dirkt68/pl3-pulseox/README.md

# Project Lab 3
## Digital Communications Project Lab
