dirkt68/pl3-pulseox/report/dirk/fe_grade_thieme.png

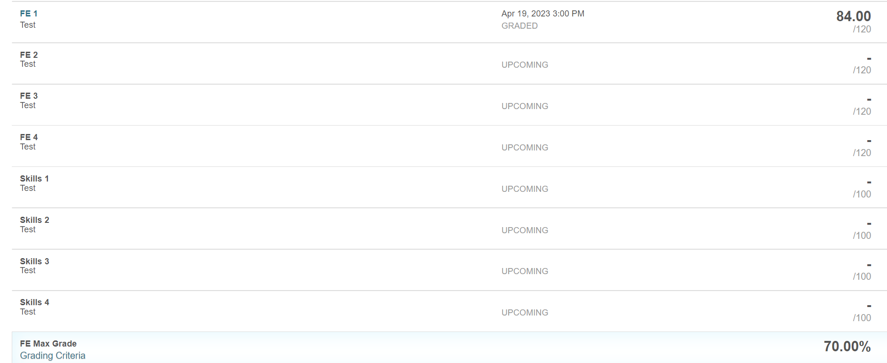
report/dirk/fe_grade_thieme.png
