dirkt68/pl3-pulseox/pcb/IC_PCB_v2/production/bom.csv

Designator | Footprint | Quantity | Value | LCSC Part #
C1 | 0603 | 1 | 2u2
C2 | 0603 | 1 | 2u2
C3 | 0603 | 1 | 10u
C4 | 0201 | 1 | 0u1
C5 | 0201 | 1 | 0u1
C6 | 0201 | 1 | 4u7
C7 | 0603 | 1 | 10u
C8 | 0201 | 1 | 0u7
C9 | 0201 | 1 | 0u1
IC1 | 14-LEAD-OESIP | 1 | MAX30102EFD+
IC2 | SON65P300X300X80-9N | 1 | MAX30205MTA+
J1 | 0522070433 | 1 | 52207-0460
R3 | 0201 | 1 | 4.7k
R4 | 0201 | 1 | 4.7k
R5 | 0201 | 1 | 4k7
R6 | 0201 | 1 | 4k7
U2 | TSOT-23-5 | 1 | ADP7182AUJZ-1.8
