dirkt68/pl3-pulseox/report/dirk/final/images/uc_setup_2.png

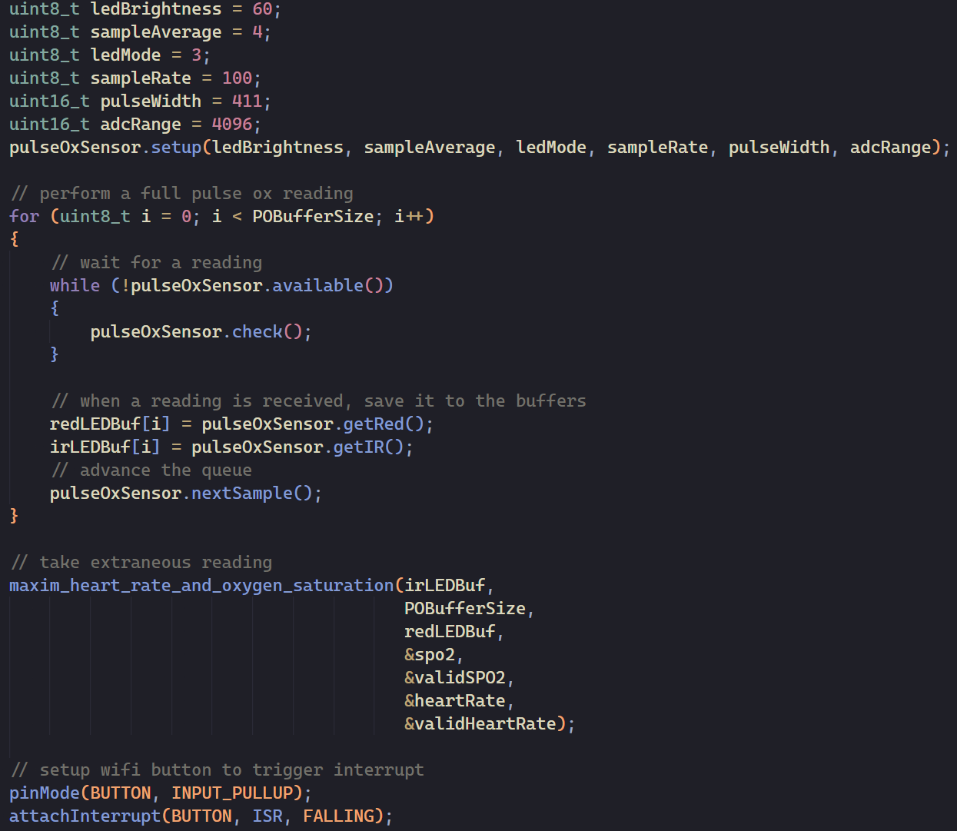
report/dirk/final/images/uc_setup_2.png
