dirkt68/pl3-pulseox/pcb/pulse_ox_wearable/pulse_ox_wearable.kicad_pcb

## KiCad design pcb/pulse_ox_wearable/pulse_ox_wearable.kicad_pcb (2023-04-01)

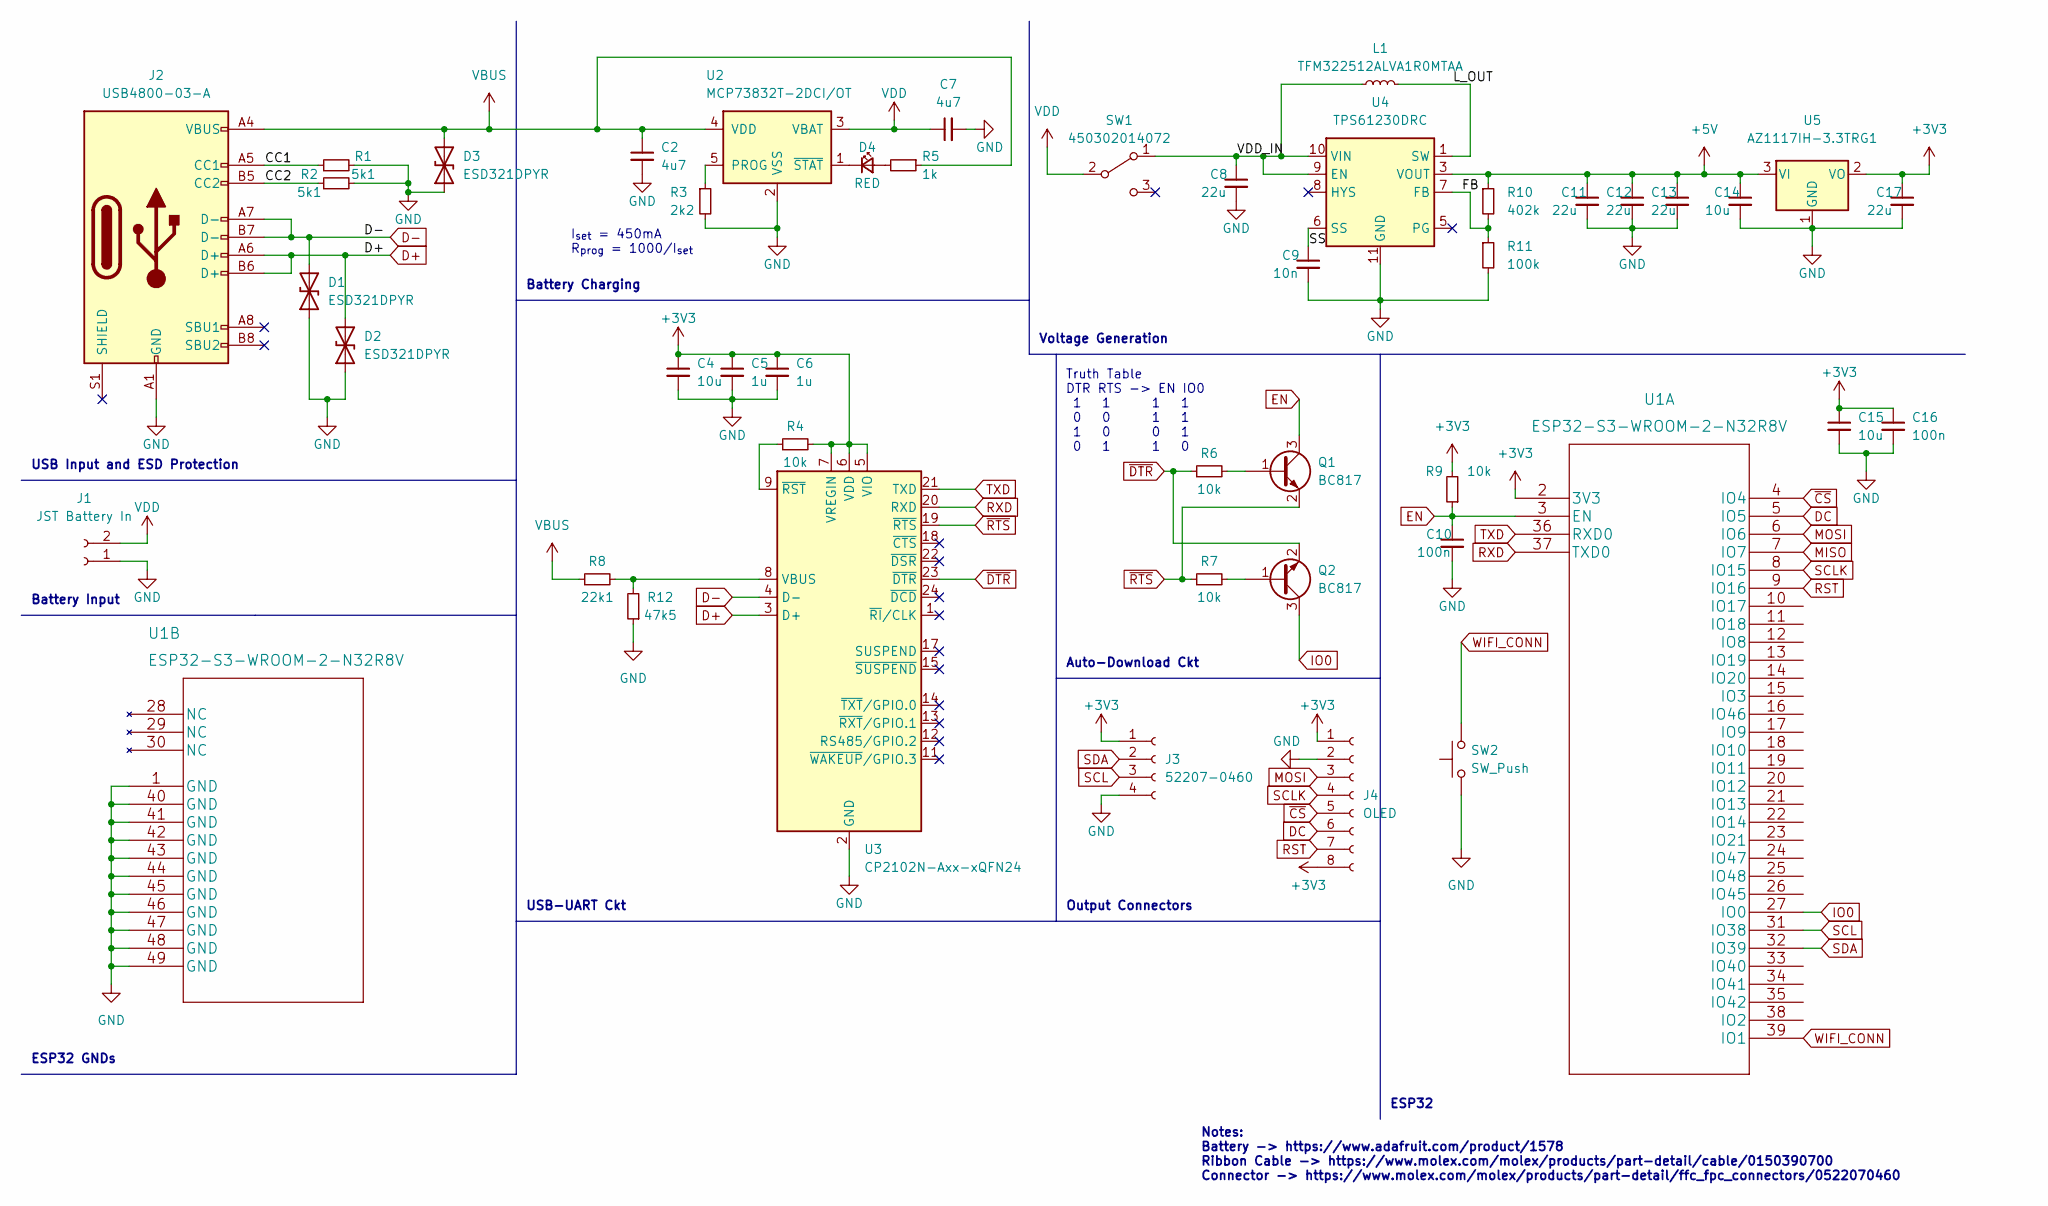
[picture p39: schematic pulse_ox_wearable.kicad_sch, Project Lab 3 - Main Board]

Parts:
C2, C7: 4u7; C_0603_1608Metric
C4, C14, C15: 10u; C_0805_2012Metric
C5, C6: 1u; C_0805_2012Metric
C8, C11, C12, C13, C17: 22u; C_1206_3216Metric
C9: 10n; C_0201_0603Metric
C10, C16: 100n; C_0603_1608Metric
D1, D2, D3: ESD321DPYR; D_0402_1005Metric
D4: RED; LED_0603_1608Metric
J1: JST Battery In; JST_PH_B2B-PH-K_1x02_P2.00mm_Vertical
J2: USB4800-03-A; USB_C_Receptacle_HRO_TYPE-C-31-M-12
J3: 52207-0460; 0522070433
J4: OLED; PinHeader_1x08_P2.54mm_Vertical
L1: TFM322512ALVA1R0MTAA; L_1210_3225Metric
Q1, Q2: BC817; SOT-23
R1, R2: 5k1; R_0201_0603Metric
R3: 2k2; R_0201_0603Metric
R4, R6, R7, R9: 10k; R_1210_3225Metric
R5: 1k; R_0805_2012Metric
R8: 22k1; R_0402_1005Metric
R10: 402k; R_0603_1608Metric
R11: 100k; R_0603_1608Metric
R12: 47k5; R_0402_1005Metric
SW1: 450302014072; SS12D00(SPDT amazon)
SW2: SW_Push; SW_SPST_B3U-1000P
U1: ESP32-S3-WROOM-2-N32R8V
U2: MCP73832T-2DCI/OT; SOT-23-5
U3: CP2102N-Axx-xQFN24; QFN-24-1EP_4x4mm_P0.5mm_EP2.6x2.6mm
U4: TPS61230DRC; Texas_S-PVSON-N10_ThermalVias
U5: AZ1117IH-3.3TRG1; SOT-223

Connections:
+3V3: C4.1, C5.1, C6.1, C15.1, C16.1, C17.1, J3.1, J4.1, J4.8, R4.2, R9.2, U1.2 (3V3), U3.5 (VIO), U3.6 (VDD), U3.7 (VREGIN), U5.2 (VO)
+5V: C11.1, C12.1, C13.1, C14.1, R10.1, U4.3 (VOUT), U4.4 (VOUT), U5.3 (VI)
/CC1: J2.A5 (CC1), R1.1
/CC2: J2.B5 (CC2), R2.1
/FB: R10.2, R11.1, U4.7 (FB)
/L_OUT: L1.2, U4.1 (SW), U4.2 (SW)
/SS: C9.1, U4.6 (SS)
/VDD_IN: C8.1, L1.1, SW1.1 (A), U4.9 (EN), U4.10 (VIN)
D+: D2.2 (A2), J2.A6 (D+), J2.B6 (D+), U3.3 (D+)
D-: D1.2 (A2), J2.A7 (D-), J2.B7 (D-), U3.4 (D-)
DC: J4.6, U1.5 (IO5)
EN: C10.1, Q1.3 (C), R9.1, U1.3 (EN)
GND: C2.2, C4.2, C5.2, C6.2, C7.2, C8.2, C9.2, C10.2, C11.2, C12.2, C13.2, C14.2, C15.2, C16.2, C17.2, D1.1 (A1), D2.1 (A1), D3.1 (A1), J1.1, J2.A1 (GND), J2.A12 (GND), J2.B1 (GND), J2.B12 (GND), J3.4, J4.2, R1.2, R2.2, R3.2, R11.2, R12.1, SW2.1, U1.1 (GND), U1.40 (GND), U1.41 (GND), U1.42 (GND), U1.43 (GND), U1.44 (GND), U1.45 (GND), U1.46 (GND), U1.47 (GND), U1.48 (GND), U1.49 (GND), U2.2 (VSS), U3.2 (GND), U3.25 (GND), U4.11 (GND), U5.1 (GND)
IO0: Q2.3 (C), U1.27 (IO0)
MISO: U1.7 (IO7)
MOSI: J4.3, U1.6 (IO6)
unnamed: D4.2 (A), R5.2
unnamed: D4.1 (K), U2.1 (~STAT)
unnamed: Q1.1 (B), R6.2
unnamed: Q2.1 (B), R7.2
unnamed: R3.1, U2.5 (PROG)
unnamed: R8.2, R12.2, U3.8 (VBUS)
unnamed: R4.1, U3.9 (~RST)
RST: J4.7, U1.9 (IO16)
RXD: U1.37 (TXD0), U3.20 (RXD)
SCL: J3.3, U1.31 (IO38)
SCLK: J4.4, U1.8 (IO15)
SDA: J3.2, U1.32 (IO39)
TXD: U1.36 (RXD0), U3.21 (TXD)
VBUS: C2.1, D3.2 (A2), J2.A4 (VBUS), J2.A9 (VBUS), J2.B4 (VBUS), J2.B9 (VBUS), R5.1, R8.1, U2.4 (VDD)
VDD: C7.1, J1.2, SW1.2 (B), U2.3 (VBAT)
WIFI_CONN: SW2.2, U1.39 (IO1)
~CS: J4.5, U1.4 (IO4)
~DTR: Q2.2 (E), R6.1, U3.23 (~DTR)
~RTS: Q1.2 (E), R7.1, U3.19 (~RTS)

Notes on the sheet:
I_{set} = 450mA R_{prog} = 1000/I_{set}
Voltage Generation
Battery Input
Truth Table DTR RTS -> EN IO0 1 1 1 1 0 0 1 1 1 0 0 1 0 1 1 0
USB-UART Ckt
ESP32
USB Input and ESD Protection
Battery Charging
Notes: Battery -> https://www.adafruit.com/product/1578 Ribbon Cable -> https://www.molex.com/molex/products/part-detail/cable/0150390700 Connector -> https://www.molex.com/molex/products/part-detail/ffc_fpc_connectors/0522070460
ESP32 GNDs
Output Connectors
Auto-Download Ckt

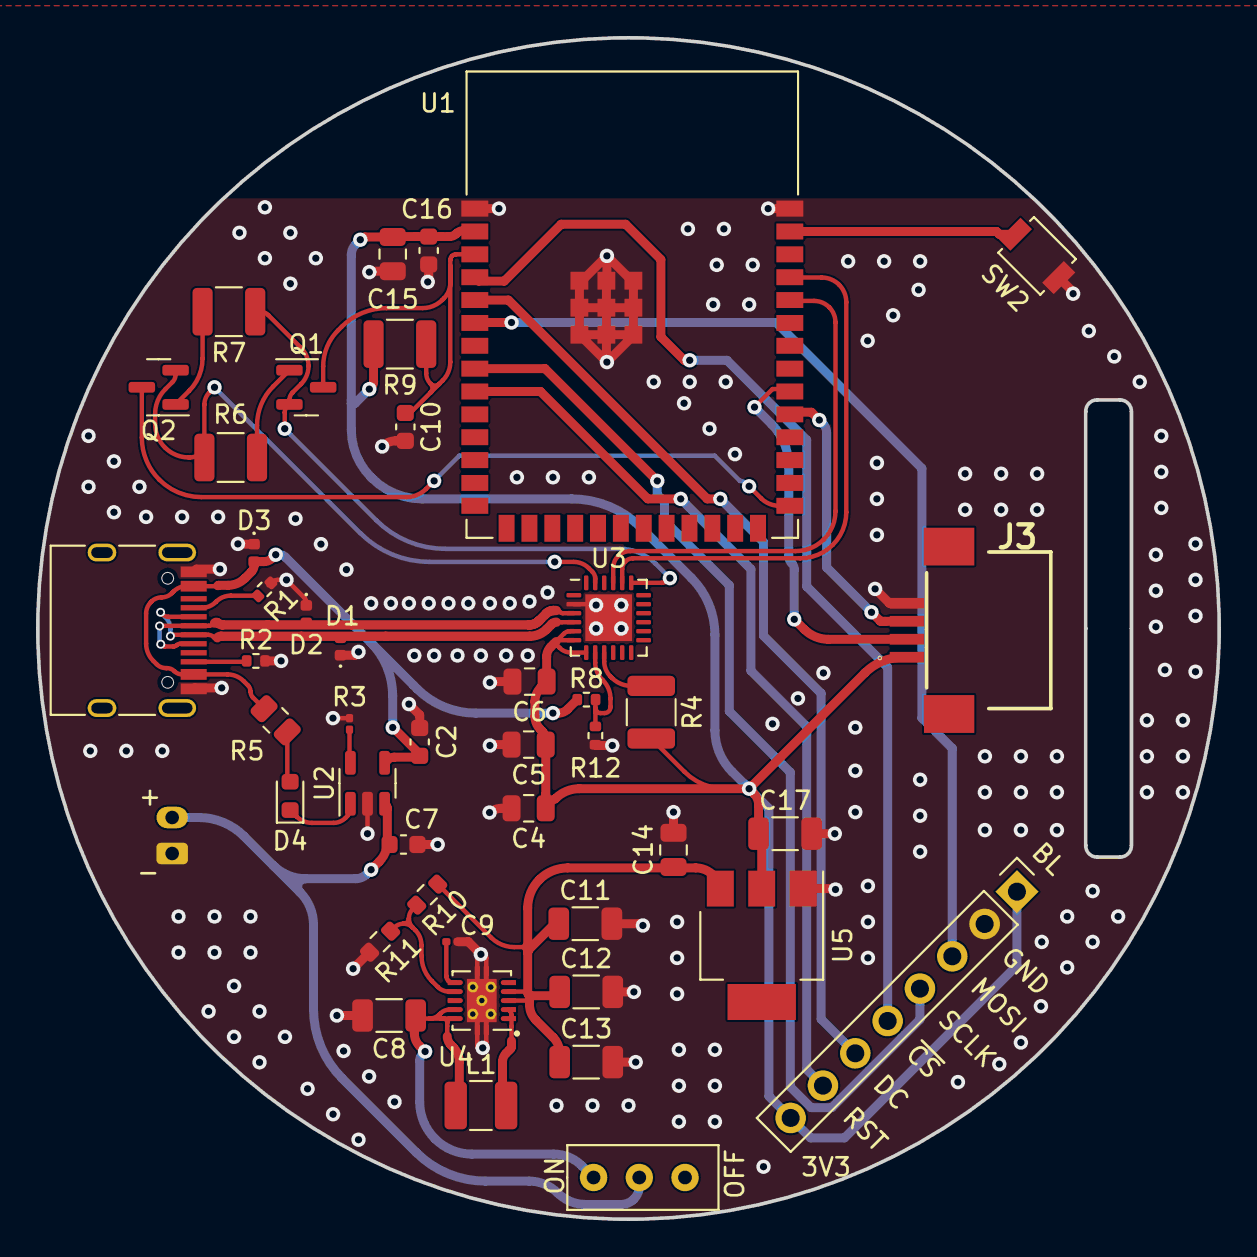
[picture p40: board pulse_ox_wearable.kicad_pcb from above]

Board: 4 copper layers, 65.6 x 65.6 mm, 45 parts (1 on the bottom side), 34 nets.
