dirkt68/pl3-pulseox/pcb/IC_PCB_v2/IC_PCB_v2.kicad_pcb

## KiCad design pcb/IC_PCB_v2/IC_PCB_v2.kicad_pcb (2023-02-22)

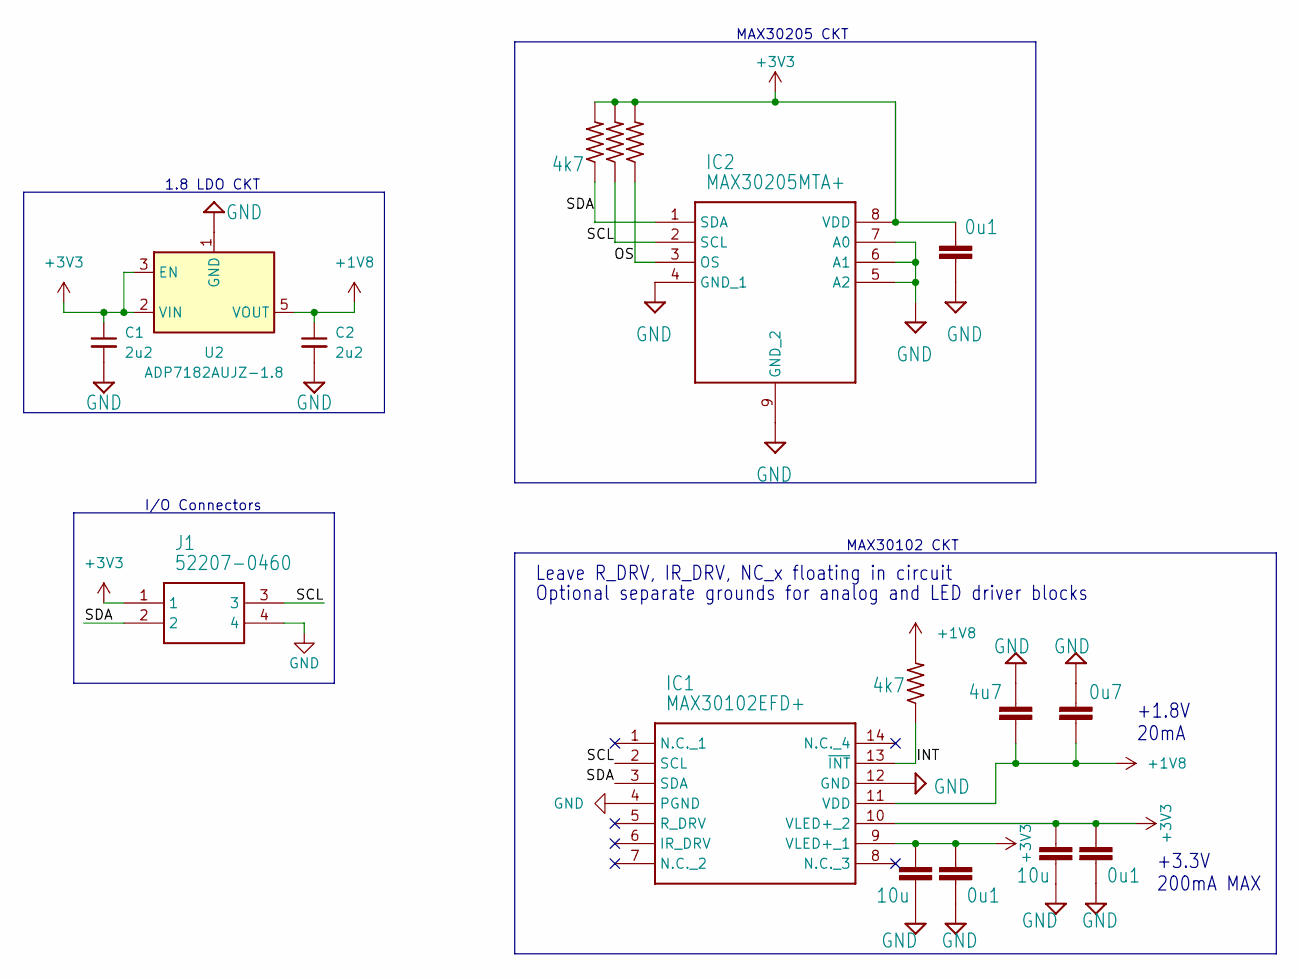
[picture p41: schematic IC_PCB_v2.kicad_sch]

Parts:
C1, C2: 2u2; C_0603_1608Metric
C3, C7: 10u; C_0603_1608Metric
C4, C5, C9: 0u1; C_0201_0603Metric_Pad0.64x0.40mm_HandSolder
C6: 4u7; C_0201_0603Metric_Pad0.64x0.40mm_HandSolder
C8: 0u7; C_0201_0603Metric_Pad0.64x0.40mm_HandSolder
IC1: MAX30102EFD+; 14-LEAD-OESIP
IC2: MAX30205MTA+; SON65P300X300X80-9N
J1: 52207-0460; 0522070433
R3, R4: 4.7k; R_0201_0603Metric_Pad0.64x0.40mm_HandSolder
R5, R6: 4k7; R_0201_0603Metric_Pad0.64x0.40mm_HandSolder
U2: ADP7182AUJZ-1.8; TSOT-23-5

Connections:
+1V8: C2.1, C6.2, C8.2, IC1.11 (VDD), R6.2, U2.5 (VOUT)
+3V3: C1.1, C3.1, C4.1, C5.1, C7.1, C9.1, IC1.9 (VLED+_1), IC1.10 (VLED+_2), IC2.8 (VDD), J1.1, R3.2, R4.2, R5.2, U2.2 (VIN), U2.3 (EN)
/INT: IC1.13 (~INT), R6.1
/OS: IC2.3 (OS), R5.1
/SCL: IC1.2 (SCL), IC2.2 (SCL), J1.3, R4.1
/SDA: IC1.3 (SDA), IC2.1 (SDA), J1.2, R3.1
GND: C1.2, C2.2, C3.2, C4.2, C5.2, C6.1, C7.2, C8.1, C9.2, IC1.4 (PGND), IC1.12 (GND), IC2.4 (GND_1), IC2.5 (A2), IC2.6 (A1), IC2.7 (A0), IC2.9 (GND_2), J1.4, U2.1 (GND)

Notes on the sheet:
+3.3V 200mA MAX
1.8 LDO CKT
+1.8V 20mA
Optional separate grounds for analog and LED driver blocks
MAX30102 CKT
MAX30205 CKT
I/O Connectors
Leave R_DRV, IR_DRV, NC_x floating in circuit

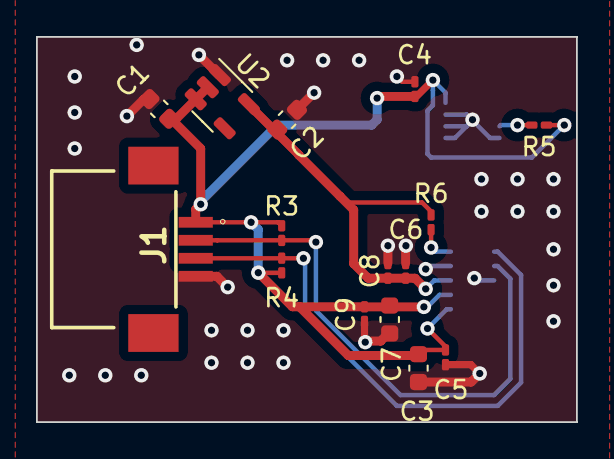
[picture p42: board IC_PCB_v2.kicad_pcb from above]

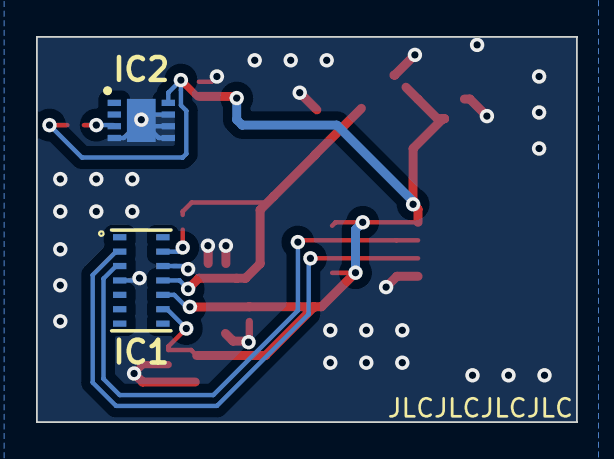
[picture p43: board IC_PCB_v2.kicad_pcb from below]

Board: 2 copper layers, 30.0 x 21.4 mm, 17 parts (2 on the bottom side), 7 nets.
