dirkt68/pl3-pulseox/(commit log)

2023-02-01 initialized repo
    [BOM-pulse_ox_wearable.csv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]
2023-02-06 added daughter PCB to git repo
    [IC_PCB.kicad_pcb, IC_PCB.kicad_sch, IC_PCB_v2.kicad_pcb, IC_PCB_v2.kicad_sch]
2023-02-08 updated for week 4
    [BOM-pulse_ox_wearable.csv, IC_PCB.kicad_pcb, IC_PCB.kicad_sch, IC_PCB_v2.kicad_pcb, IC_PCB_v2.kicad_sch, bom.csv, designators.csv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]
2023-02-22 uploaded code and stuff
    [IC_PCB_v2.kicad_pcb, IC_PCB_v2.kicad_sch, bom.csv, designators.csv, positions.csv, pulse_ox_wearable.kicad_pcb, pulse_ox_wearable.kicad_sch]
